byandersen/standalone/hardware/3D_Model_v2/Controller_first_idea.jpg

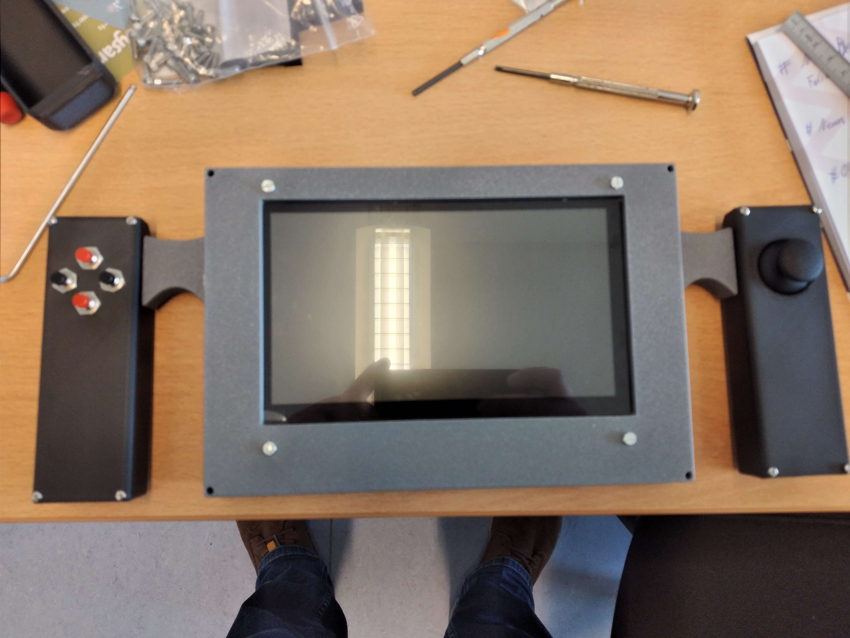
hardware/3D_Model_v2/Controller_first_idea.jpg
