byandersen/standalone/hardware/3D_Model_v2/Controller_inside_handle.png

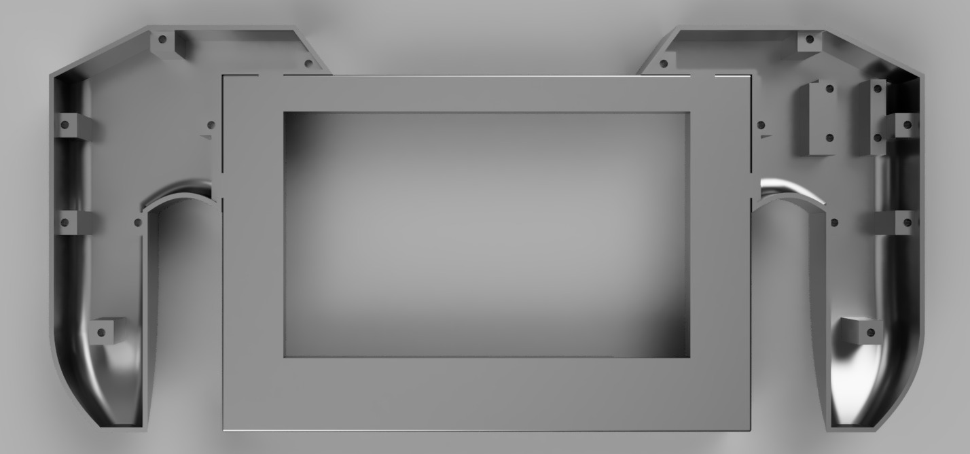
hardware/3D_Model_v2/Controller_inside_handle.png
