byandersen/standalone/README.md

# TEAM STANDALONE

**Unsere Vision**
- Ein Mikroskop sollte für sich stehen und nicht auf andere Geräte angewiesen sein.
