byandersen/standalone/hardware/3D_Model_v2/circuit_diagram.png

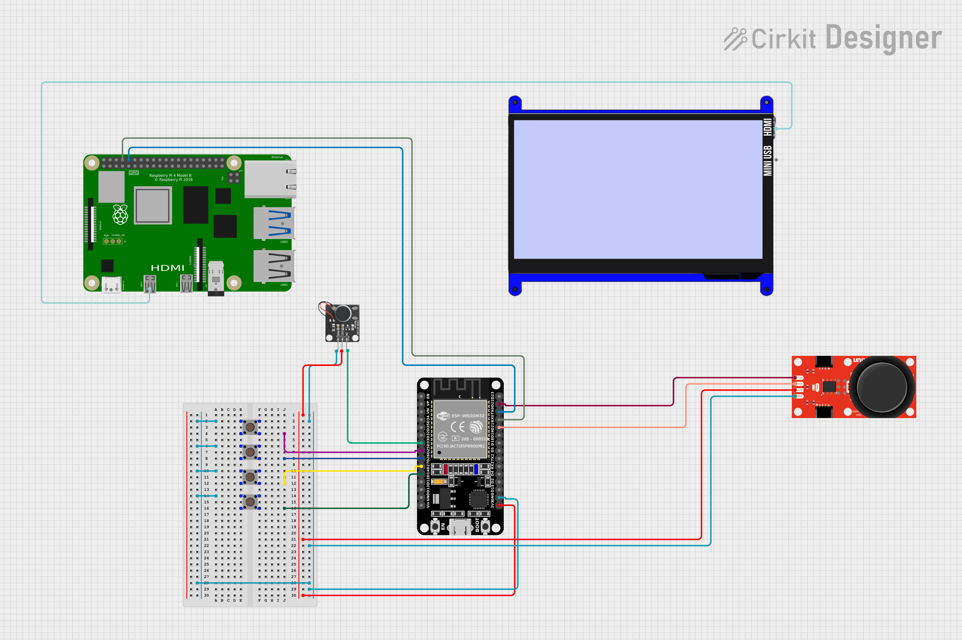
hardware/3D_Model_v2/circuit_diagram.png
