byandersen/standalone/hardware/3D_Model_v2/Controller_completely.png

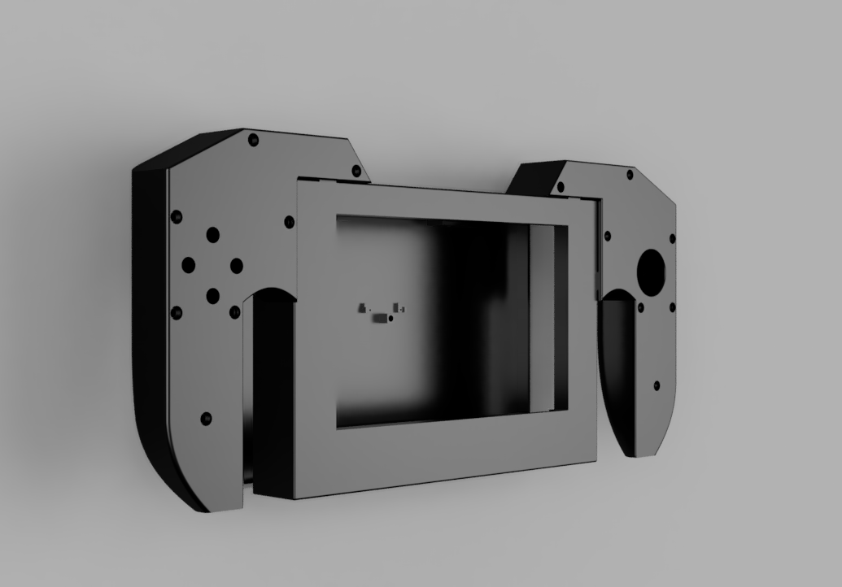
hardware/3D_Model_v2/Controller_completely.png
