byandersen/standalone/hardware/3D_Model_v2/controller_right_grip.stl

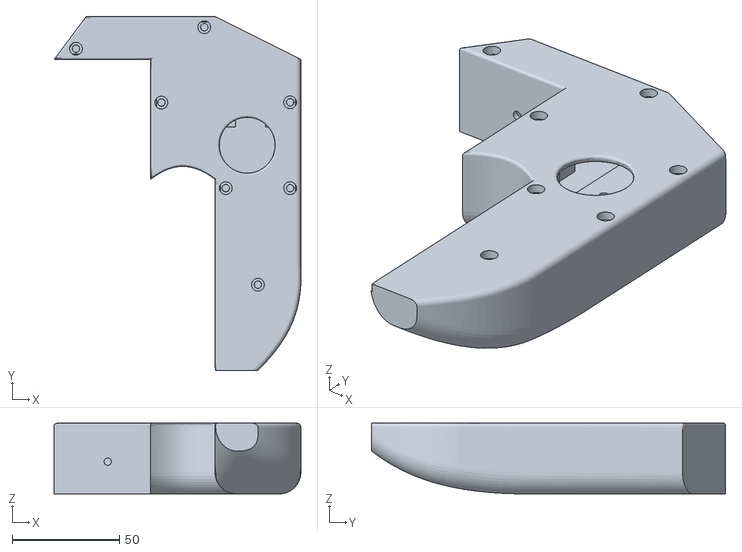
[picture p5: CAD file, 2025-07-22]
hardware/3D_Model_v2/controller_right_grip.stl
115.0 x 165.0 x 33.0
