byandersen/standalone/hardware/3D_Model_v2/controller_body.stl

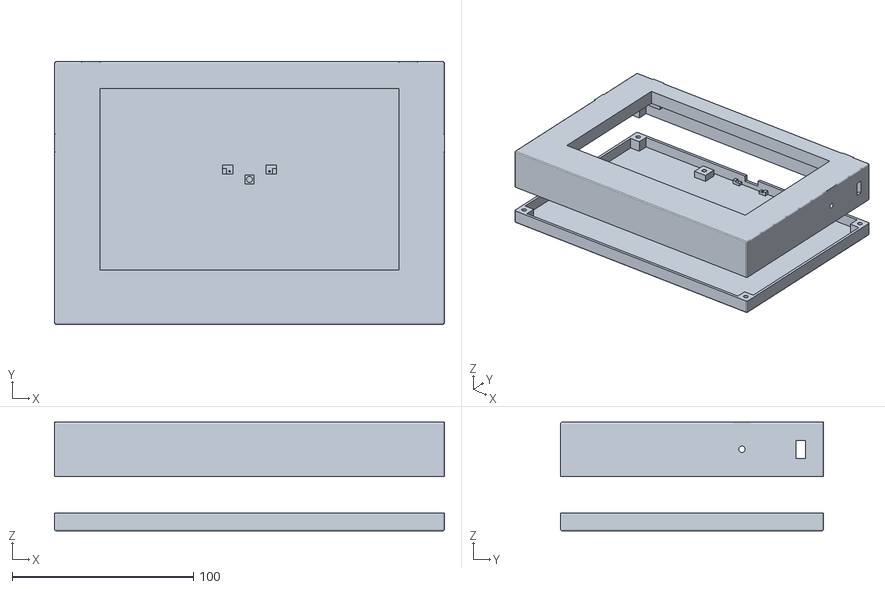
[picture p6: CAD file, 2025-07-22]
hardware/3D_Model_v2/controller_body.stl
215.0 x 145.0 x 60.0
