byandersen/standalone/hardware/3D_Model_v2/microcontroller_holder.stl

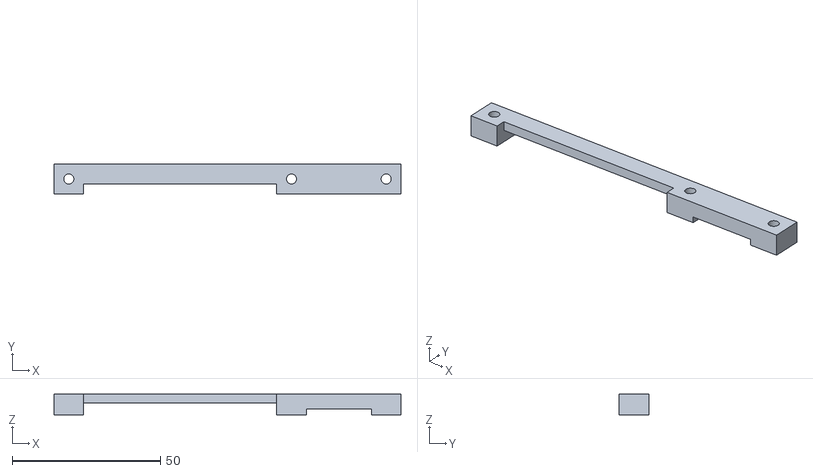
[picture p8: CAD file, 2025-07-22]
hardware/3D_Model_v2/microcontroller_holder.stl
117.0 x 10.0 x 7.00
