byandersen/standalone/hardware/3D_Model_v1/Finale Dateien/Screen_Embedded System_back_14.05.2025.stl

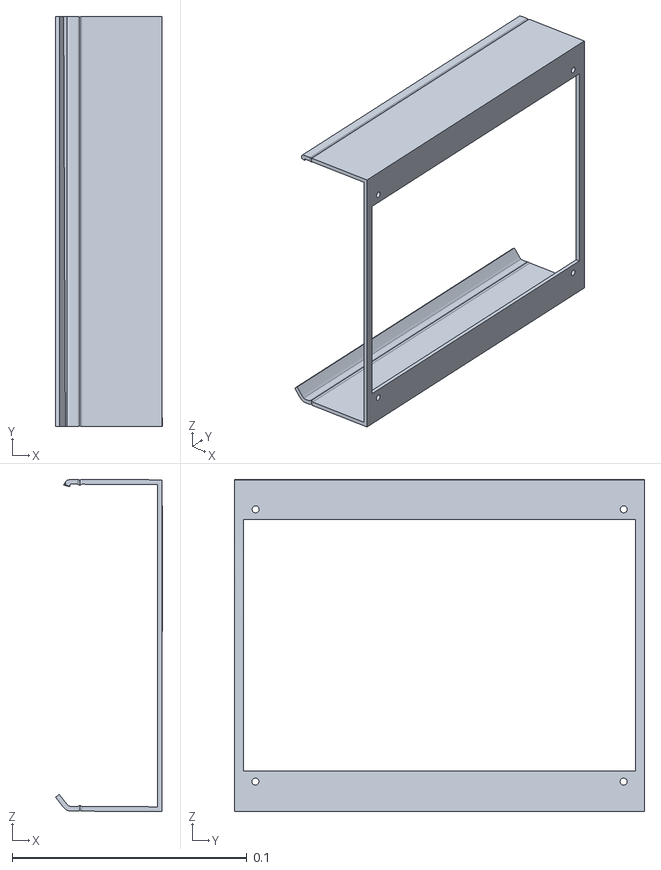
[picture p9: CAD file, 2025-07-22, an earlier design]
hardware/3D_Model_v1/Finale Dateien/Screen_Embedded System_back_14.05.2025.stl
0.0456 x 0.175 x 0.141
