byandersen/standalone/hardware/3D_Model_v1/Finale Dateien/Screen_Embedded System_Gehäuse hinten.stl

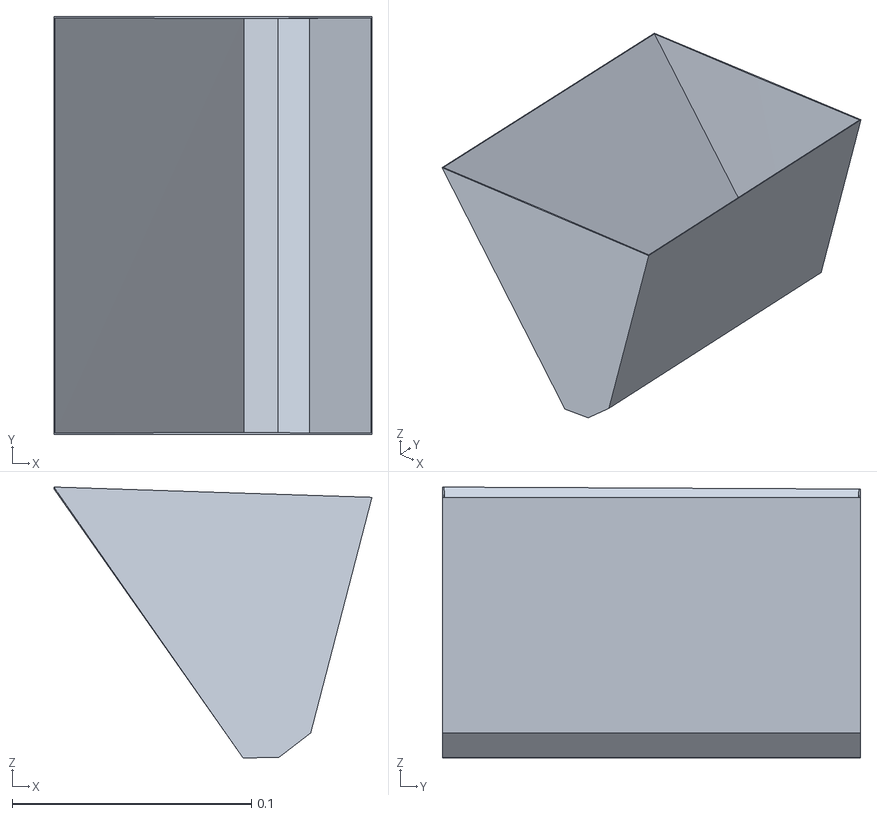
[picture p11: CAD file, 2025-07-22, an earlier design]
hardware/3D_Model_v1/Finale Dateien/Screen_Embedded System_Gehäuse hinten.stl
0.133 x 0.175 x 0.113
