byandersen/standalone/hardware/3D_Model_v1/Finale Dateien/Screen_Embedded Systems_firebeetle_09.05.2025.stl

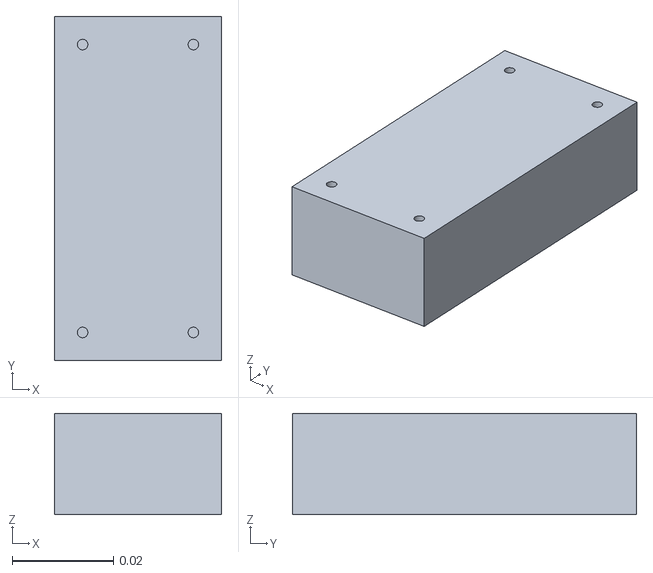
[picture p12: CAD file, 2025-07-22, an earlier design]
hardware/3D_Model_v1/Finale Dateien/Screen_Embedded Systems_firebeetle_09.05.2025.stl
0.033 x 0.068 x 0.02
