byandersen/standalone/hardware/3D_Model_v1/Finale Dateien/Screen_Embedded Systems_buttons.stl

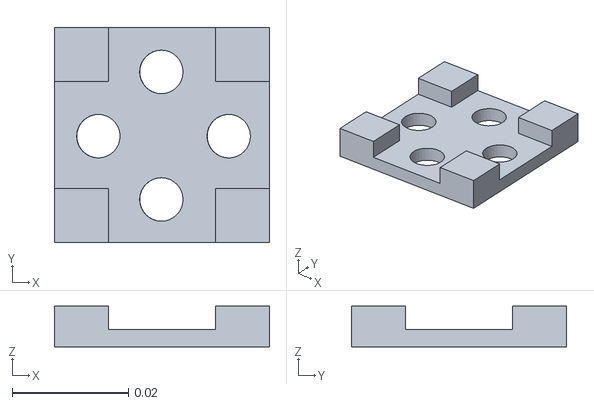
[picture p14: CAD file, 2025-07-22, an earlier design]
hardware/3D_Model_v1/Finale Dateien/Screen_Embedded Systems_buttons.stl
0.037 x 0.037 x 0.007
