byandersen/standalone/hardware/3D_Model_v1/Finale Dateien/Screen_Embedded System_controller re_14.05.2025.stl

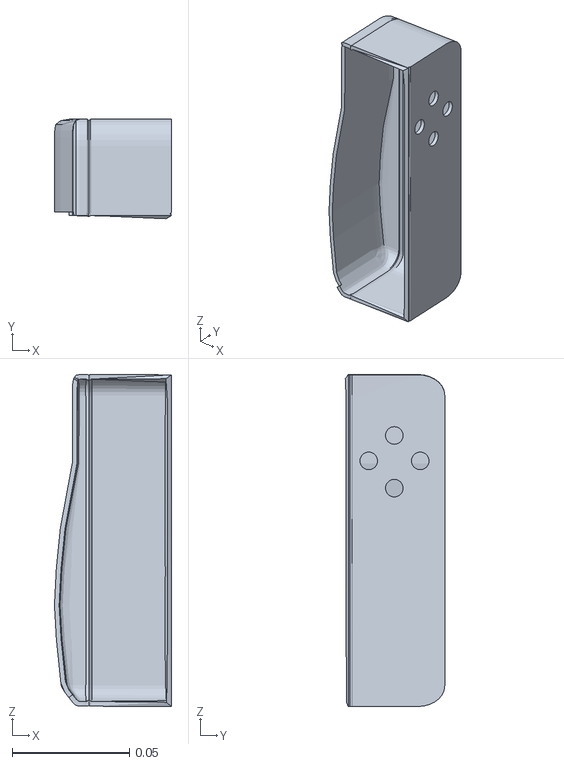
[picture p15: CAD file, 2025-07-22, an earlier design]
hardware/3D_Model_v1/Finale Dateien/Screen_Embedded System_controller re_14.05.2025.stl
0.0499 x 0.0424 x 0.141
