byandersen/standalone/hardware/3D_Model_v1/Finale Dateien/Screen_Embedded System_Halterung Gehäuse vorne.stl

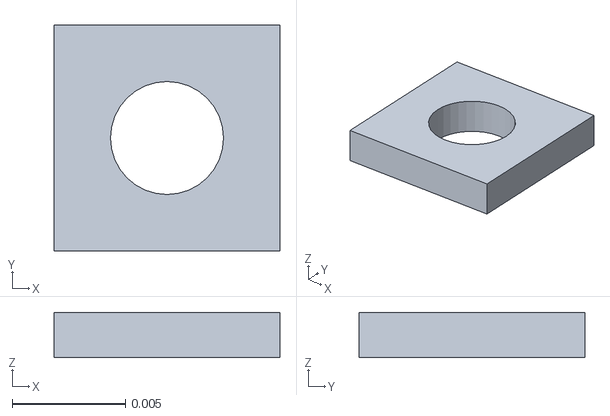
[picture p16: CAD file, 2025-07-22, an earlier design]
hardware/3D_Model_v1/Finale Dateien/Screen_Embedded System_Halterung Gehäuse vorne.stl
0.01 x 0.01 x 0.002
