byandersen/standalone/hardware/3D_Model_v1/Finale Dateien/Screen_Embedded System_Halterung Gehäuse hinten.stl

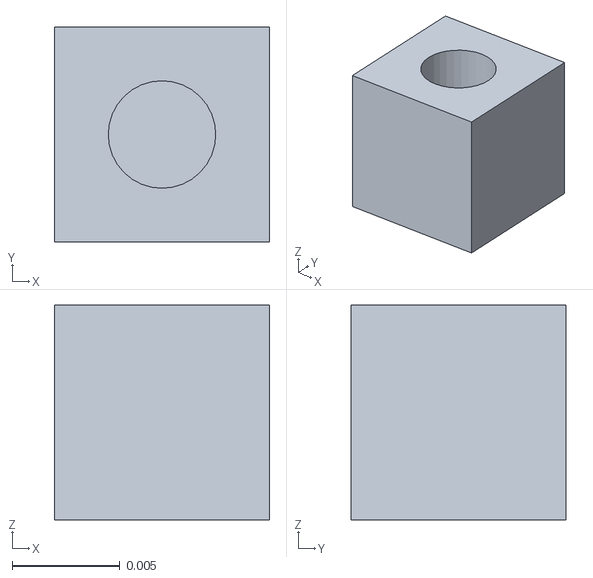
[picture p17: CAD file, 2025-07-22, an earlier design]
hardware/3D_Model_v1/Finale Dateien/Screen_Embedded System_Halterung Gehäuse hinten.stl
0.01 x 0.01 x 0.01
