byandersen/standalone/(list of files, cad)

Other CAD files:
hardware/3D_Model_v1/Prozess/Screen_Embedded System_2.7.blend
hardware/3D_Model_v2/controller_completely.f3d
