byandersen/standalone/extensions/controller_and_stage_control/logger.py

import logging
import sys

logger = logging.getLogger("standalone")
# logger.propagate = False
logger.setLevel(logging.DEBUG)
formatter = logging.Formatter("%(asctime)s - %(name)s - %(levelname)s - %(message)s")

ch = logging.StreamHandler(sys.stdout)
ch.setLevel(logging.DEBUG)
ch.setFormatter(formatter)

logger.addHandler(ch)
