byandersen/standalone/(commit log)

2025-06-12 Aktueller Stand der Web App
2025-06-18 Für Buttons usw. Components erstellt, CSS verbessert, Schlagschatten für Controller Buttons hinzugefügt, Funktionalität Capture via Button B hinzugefügt
2025-07-14 Gallerie eingebaut, noch nicht fertig. Minimap ebenso provisorisch in die Sidebar eingebaut. Buttons so verändert, dass aktuell per Taste A Menü und Gallerie aufgerufen werden. Bei weiterem Tastendru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
2025-07-16 Weiter an Gallerie gearbeitet. Hauptscreen zeigt nun nur Bilder an und Sidebar zeigt Bilderdaten an. Bisher werden alle Bilder und Daten angezeigt. Nächster Schritt ist, nur einzelne Bilder + Daten a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
2025-07-16 add controller connector
2025-07-17 Galerie zeigt nur ein Bild + Daten zur Zeit an, Nutzende können per Buttons zwischen den Bildern wechseln. WebSocket wurde erstmalig vorbereitet, ist aber noch nicht fertig
2025-07-18 nav über Menü hinzugefügt, Buttons gefixt, dient als Back-Up
2025-07-18 am CSS weitergearbeitet, Menü rausgenommen, buttons neu belegt
2025-07-19 remove threading issue
2025-07-19 add stage movement
2025-07-19 fix serial listener and add black formatting
    [csc_extension.py, logger.py, serial_listener.py, stage_controller.py, websocket_server.py]
2025-07-21 add z-axis joystick control
2025-07-21 Buttons Legende + Bezeichnungen, Joystick erneuert, Back-Up für neue Controller-Button Funktionalität
2025-07-21 Button Legende angepasst, für neue Button Belegung vorbereitet
2025-07-21 add joystick and button modes
2025-07-22 Kommentare ergänzt, Galerie lädt nun jedes Mal beim Öffnen der Galerie neu
2025-07-22 hardware folder added and Fusen360 file attached
    [controller.f3d]
2025-07-22 readme file attached
2025-07-22 3D model ver1
    [Screen_Embedded System_2.7.blend, Screen_Embedded System_Gehäuse hinten.stl, Screen_Embedded System_Halterung Gehäuse hinten.stl, Screen_Embedded System_Halterung Gehäuse vorne.stl, Screen_Embedded System_Screen_14.05.2025.stl, Screen_Embedded System_back_14.05.2025.stl, Screen_Embedded System_controller li_14.05.2025.stl, Screen_Embedded System_controller re_14.05.2025.stl]
2025-07-22 3D model and controller code uploaded
    [controller_body.stl, controller_completely.f3d, controller_left_grab.stl, controller_right_grip.stl, microcontroller_holder.stl]
